mnigmann/people-counter/people_counter.png

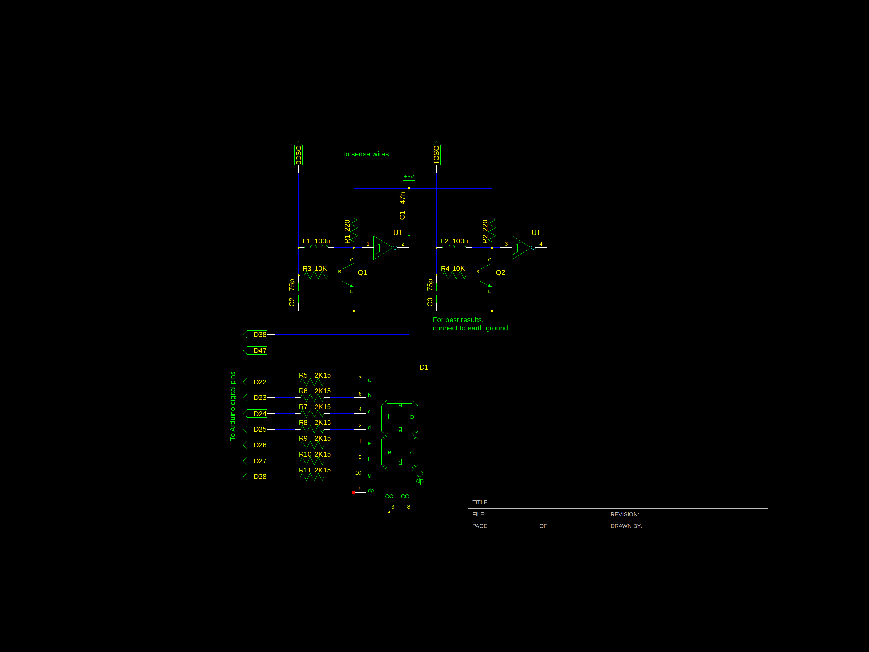
people_counter.png
