mnigmann/people-counter/(commit log)

2021-07-10 Update schematic and add image
    [people_counter.sch]
2021-08-08 Fixed problem with RX
    [people_counter.c]
